hemsara221/Vehicle_Engine_Knock_Detector/Figure_1.png

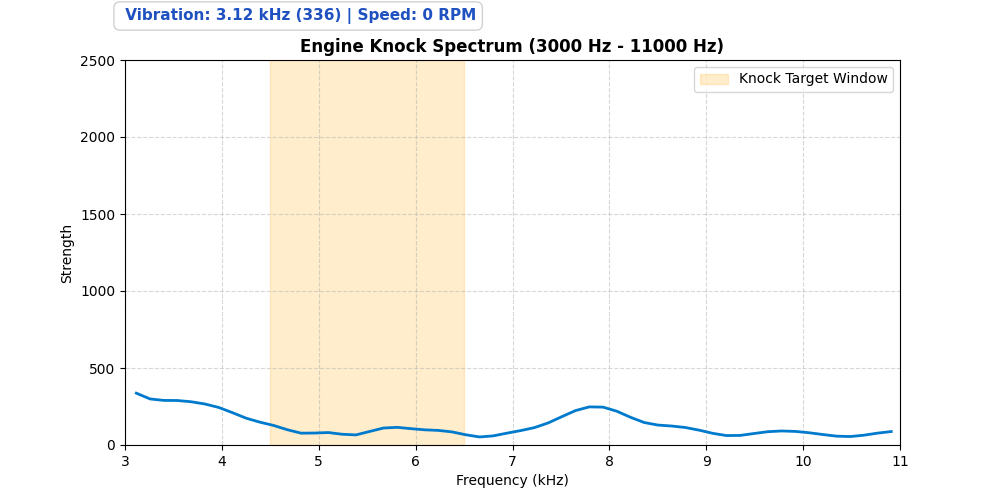
Figure_1.png
