hemsara221/Vehicle_Engine_Knock_Detector/Amplifier_Schematic.pdf

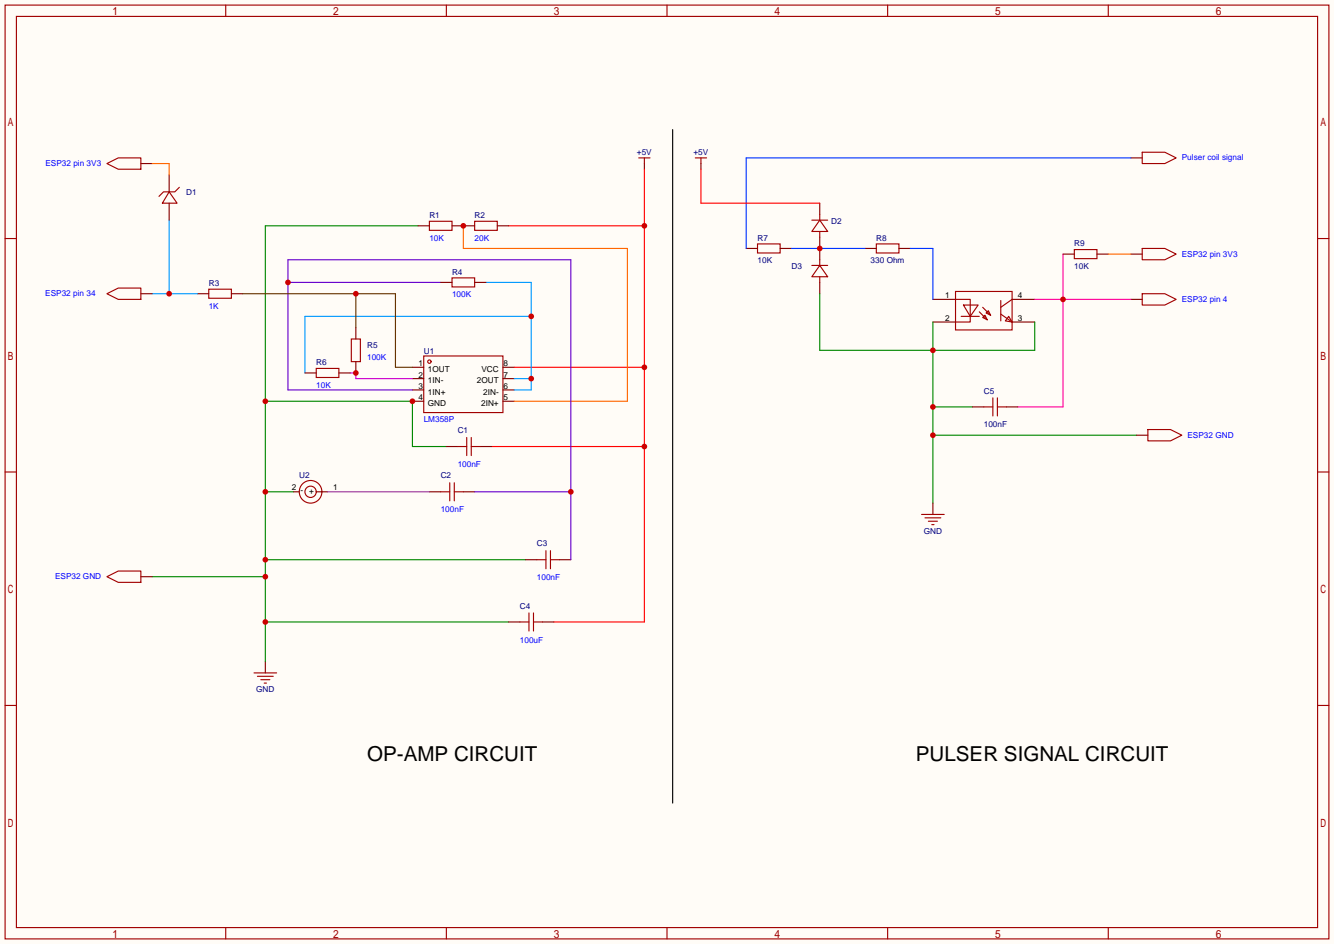
[picture p2: page 1]
